hriday880/laser-tag_hardware/estimate.pdf

# Laser Tag Mark 6 - Exact Amazon Shopping List

Component | Pack Size | Packs | Total QTY | Exact Cost | Amazon Link
TSOP1838 IR Receivers | Pack of 5 | 10 Packs | 50 Pcs | INR 890 | Link Provided
0.1uF Ceramic Capacitors | Pack of 50 | 1 Pack | 50 Pcs | INR 99 | Link Provided
5mm 940nm IR LEDs | Pack of 25 | 1 Pack | 25 Pcs | INR 265 | Link Provided
DIY 18650 Power Module | 1 Module | 8 Pcs | 8 Pcs | INR 560 | Link Provided
18650 Lithium-Ion Battery | Pack of 10 | 1 Pack | 10 Pcs | INR 915 | Link Provided

## EXACT TOTAL COST: INR 2,729
