hriday880/laser-tag_hardware/mark_fx/gun_pinout.png

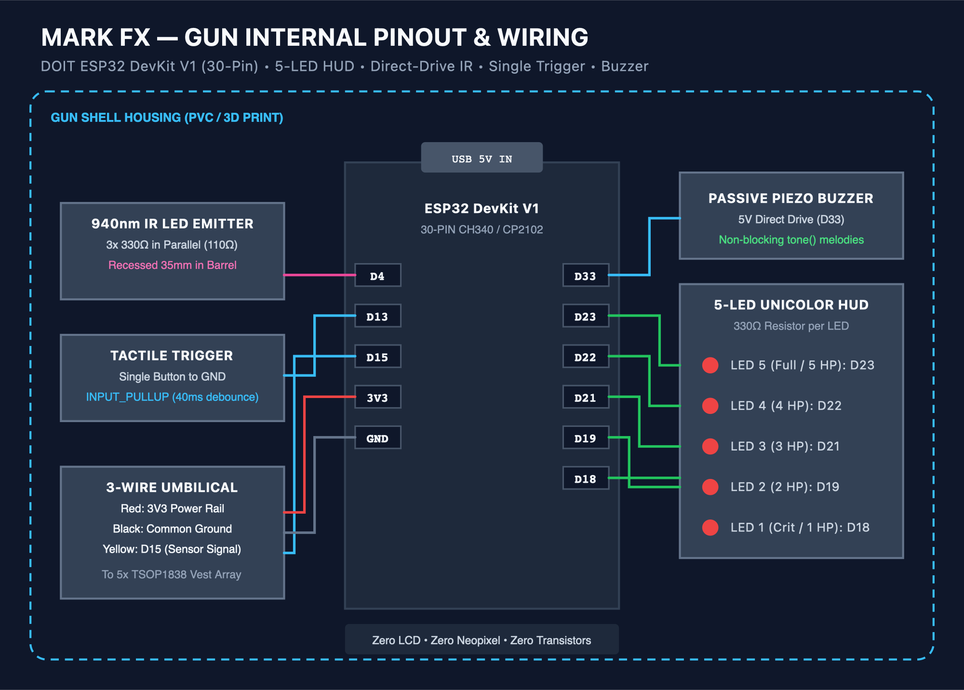
mark_fx/gun_pinout.png
