hriday880/laser-tag_hardware/mark_fx/vest_harness.png

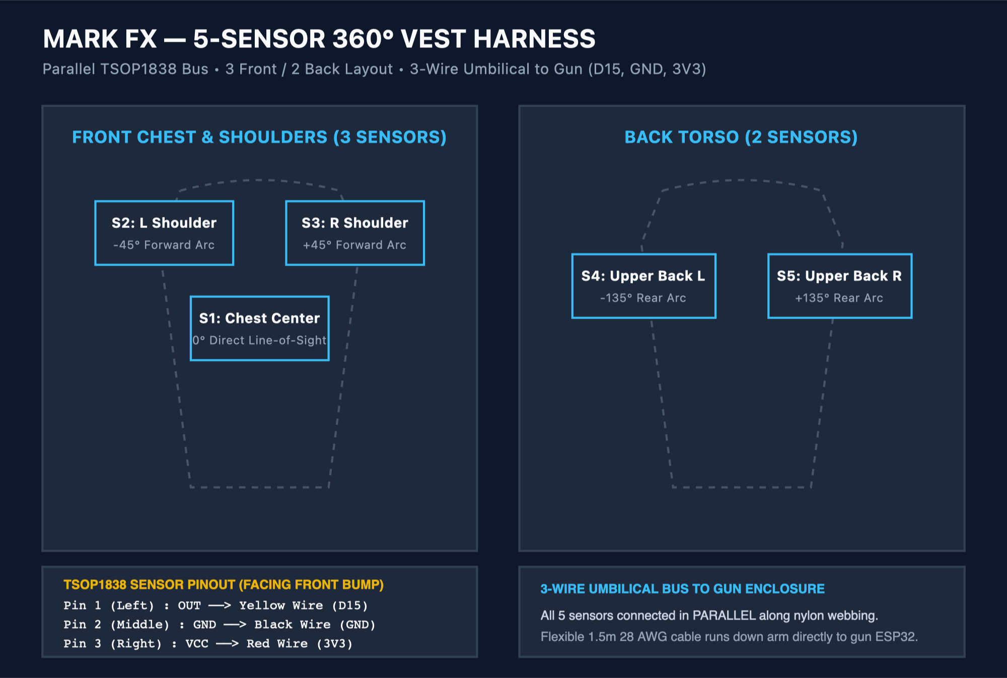
mark_fx/vest_harness.png
