hriday880/laser-tag_hardware/prototype_mark_6/pin_diagram.png

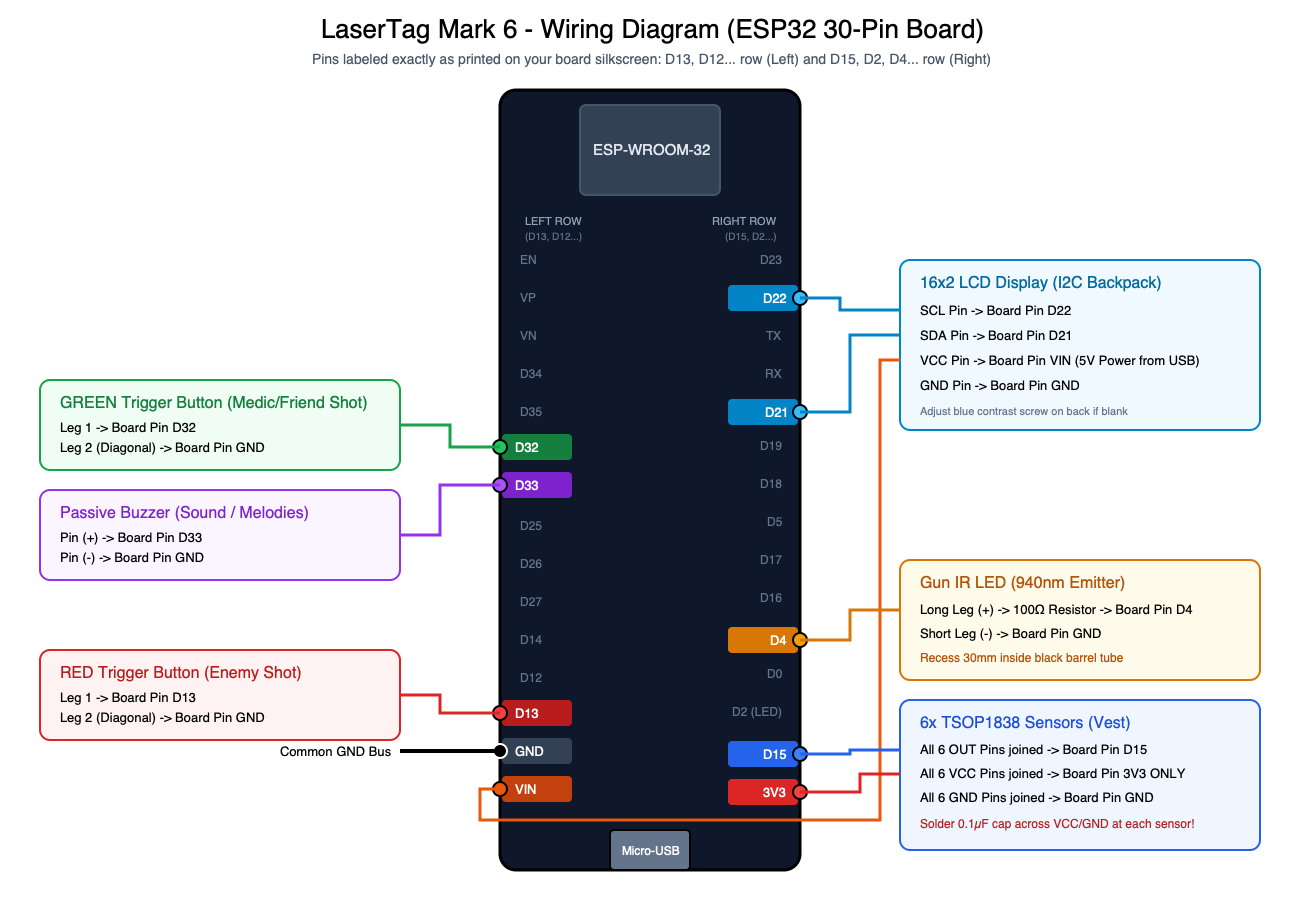
prototype_mark_6/pin_diagram.png
