hriday880/laser-tag_hardware/prototype_mark_6/pin_diagram_detailed.png

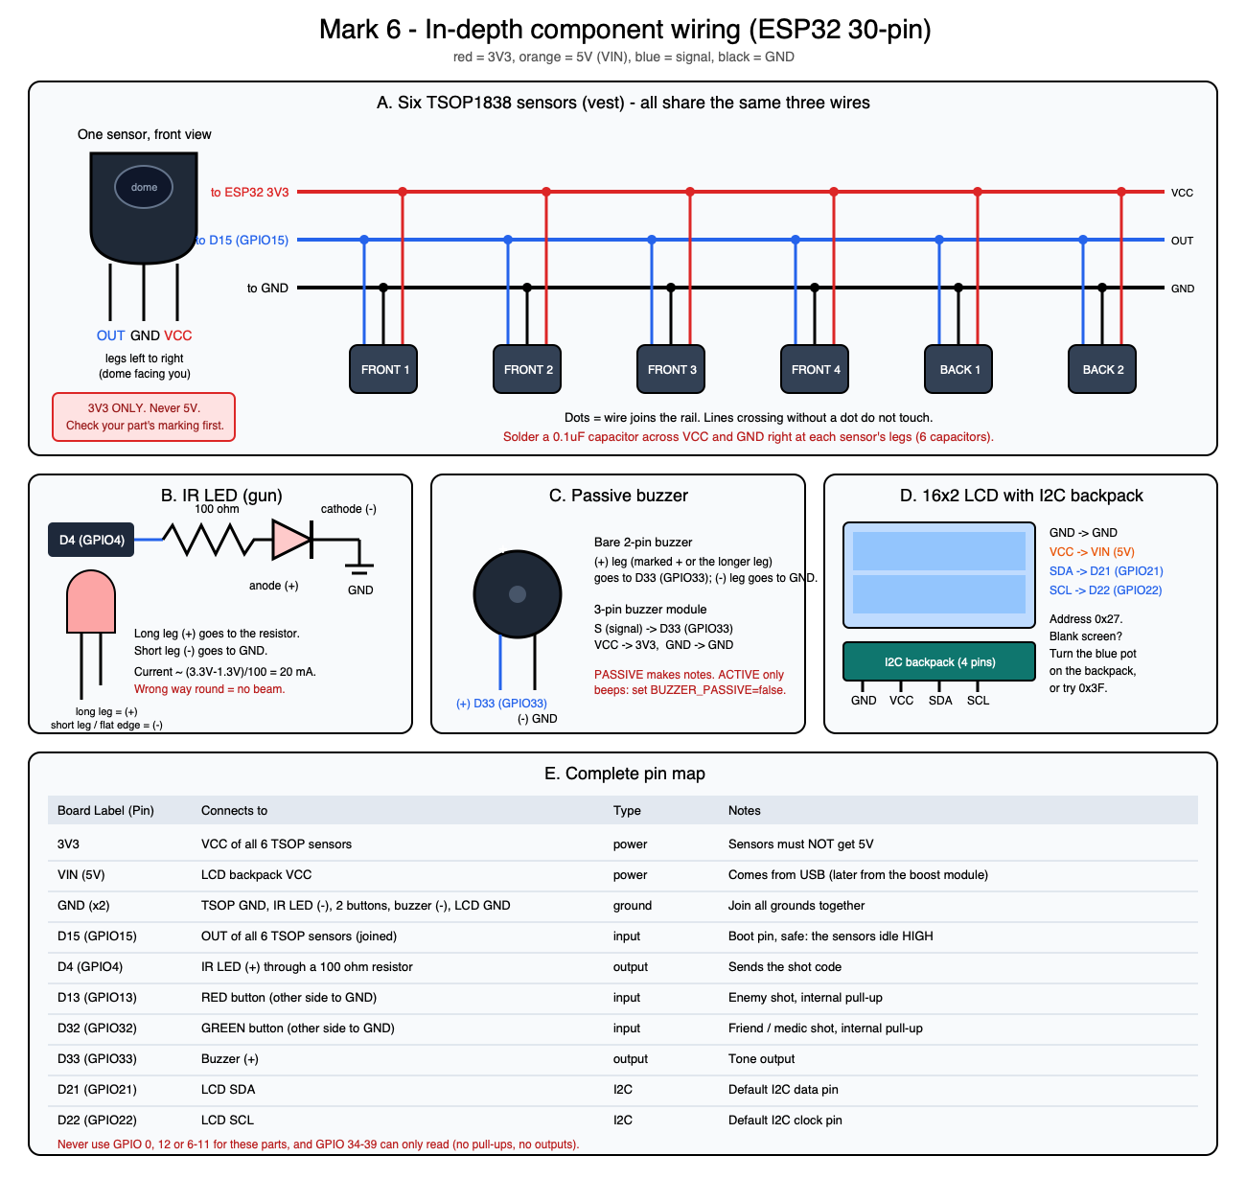
prototype_mark_6/pin_diagram_detailed.png
