hriday880/laser-tag_hardware/mark_fx/wiring_schematic.png

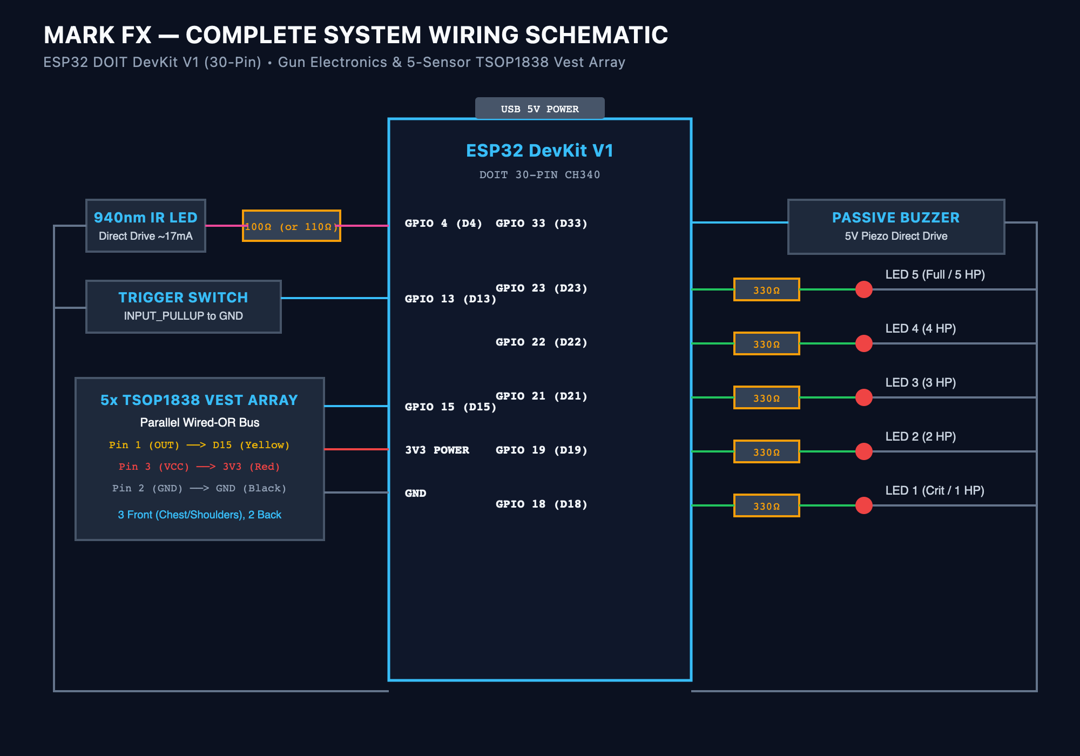
mark_fx/wiring_schematic.png
