hriday880/laser-tag_hardware/prototype_mark_6/trigger_wiring.png

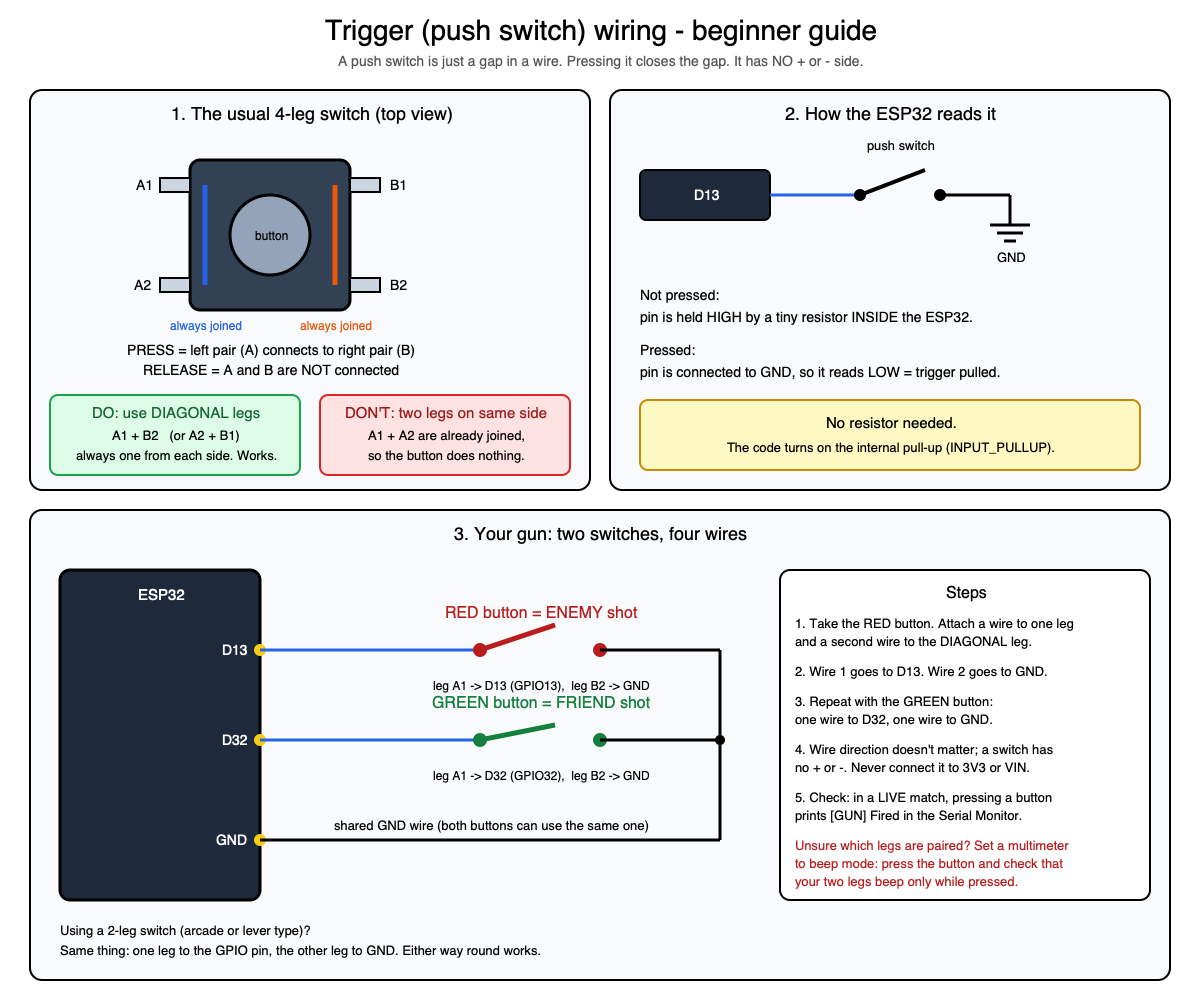
prototype_mark_6/trigger_wiring.png
