hriday880/laser-tag_hardware/TEST_READY.md

# TEST READY — Mark FX Laser Tag Test Suite

## Status: READY & VERIFIED

The automated opaque-box test suite for the **Mark FX** ESP32 Laser Tag System is complete, verified, and ready for continuous integration and acceptance testing.

- **Test Suite Location**: `/Users/admin/Documents/LaserTag-hardware/mark_fx/tests/`
- **Master Test Runner**: `/Users/admin/Documents/LaserTag-hardware/mark_fx/tests/run_tests.py`
- **Test Infrastructure Documentation**: `/Users/admin/Documents/LaserTag-hardware/TEST_INFRA.md`
- **Execution Command**: `python3 mark_fx/tests/run_tests.py`
- **Total Test Cases**: 93
- **Test Pass Rate**: 100% (93 passed, 0 failed, 0 errors)
- **Execution Time**: ~0.25 seconds (Zero external dependencies)

---

## 4-Tier Test Coverage Breakdown

| Tier | Category | Test Cases | Status | Key Coverage Areas |
|---|---|---|---|---|
| **Tier 1** | Feature Coverage | **45** | PASS | Happy path validation across all 8 core features: IR Direct Drive (100Ω/110Ω 15-20mA), 5-LED HUD states, Audio note scheduler, 40ms Trigger debounce, 8-Player NEC codes (P1..P8), 5-sensor TSOP vest (<5mA), WiFi sync, and Standalone fallback. |
| **Tier 2** | Boundary & Corner Cases | **35** | PASS | Stress & limits testing: min/max IR current (15mA–20mA), HUD power budget (<25mA), TSOP budget (<5mA), 39ms bounce cutoff rejection, 41ms press acceptance, rapid trigger burst suppression, 0 HP elimination, 5 HP heal clamp, 1 HP panic pulse sync, corrupted IR codes, repeat codes, and traitor strike escalation. |
| **Tier 3** | Cross-Feature Combinations | **8** | PASS | Pairwise concurrent interactions: Trigger during audio playback, hit while firing, spawn shield blocking hits during audio, mid-game server disconnect preservation, 1 HP panic pulse during muzzle flash, medic heal during hit cooldown, trigger lockout during respawn, and server re-discovery. |
| **Tier 4** | Real-World Application Scenarios | **5** | PASS | Full end-to-end match lifecycles: 4v4 team match with First Blood, Kills, and Finisher bonus; Medic friendly fire strikes into Traitor conversion; Sudden Death instant elimination; Offline backyard skirmish with zero WiFi; Network glitch with seamless state preservation and recovery. |
| **TOTAL** | **Comprehensive Suite** | **93** | **100% PASS** | **Complete coverage of Requirements R1–R6 and Acceptance Criteria AC-1..AC-11** |

---

## Quick Start / How to Run

```bash
# Run all 93 tests
python3 mark_fx/tests/run_tests.py

# Run with verbose output
python3 mark_fx/tests/run_tests.py --verbose

# Run individual tiers
python3 mark_fx/tests/run_tests.py --tier 1    # 45 Feature Coverage tests
python3 mark_fx/tests/run_tests.py --tier 2    # 35 Boundary & Corner tests
python3 mark_fx/tests/run_tests.py --tier 3    # 8 Cross-Feature tests
python3 mark_fx/tests/run_tests.py --tier 4    # 5 Real-World Scenarios

# Run individual modules
python3 mark_fx/tests/run_tests.py --module test_electrical_safety
python3 mark_fx/tests/run_tests.py --module test_nec_protocol
python3 mark_fx/tests/run_tests.py --module test_hud_audio_engine
python3 mark_fx/tests/run_tests.py --module test_trigger_timing
python3 mark_fx/tests/run_tests.py --module test_server_protocol
python3 mark_fx/tests/run_tests.py --module test_standalone_mode
python3 mark_fx/tests/run_tests.py --module test_cross_feature_matrix
python3 mark_fx/tests/run_tests.py --module test_real_world_scenarios
```
