hriday880/laser-tag_hardware/(commit log)

2026-10-17 Initial commit: ESP32 Laser Tag hardware prototypes (Mark 1 - Mark 6), firmware, server, diagrams, and blueprints
    [classes.csv, estimate.csv]
2026-10-19 feat(mark_fx): Add production-ready Mark FX 8-player laser tag hardware, firmware, schematics, and test suite
2026-10-19 feat(mark_fx): Add visual PNG schematics and hardened firmware subsystems
2026-10-19 test(mark_fx): Add 21-case adversarial challenger firmware stress suite
2026-10-19 fix(mark_fx): Ensure low-health acoustic heartbeat retries immediately after higher-priority melody finishes
    [mark_fx.ino]
2026-10-19 fix(mark_fx): Lock in final remediation fixes verified by Victory Auditor
    [mark_fx.ino]
2026-10-30 fix(mark_fx): Move struct Note to top of file to satisfy Arduino IDE preprocessor
    [mark_fx.ino]
2026-11-02 feat(mark_fx): Add Mark FX referee dashboard, ESP-NOW failsafe fallback, and expanded test suite
    [mark_fx.ino, test_real_world_scenarios.py, test_server_protocol.py]
